samelyuk/volvo-rti-retrofit/(threads)

Thread 2 (2024-08-07):

Inquiry about MCP2025 and Possible Alternatives

Nikolein, 2024-08-07:
Good day,

Where did you purchase the MCP2025 that you use for the steering wheel buttons? Are there alternatives such as the MCP2515?

Best regards,
Niko de Vries

samelyuk, 2024-08-07:
Hello,
I bought the MCP 2025 on tme.eu . You can also use the MCP 2003 or other LIN bus transceiver. The MCP 2515 is for the CAN bus.

Nikolein, 2024-08-07:
Did you order them in 3.3V or 5V?

Closed 2024-08-07.

Thread 3 (2024-08-12):

Verification of Connections: Car to IC and Arduino

Nikolein, 2024-08-12:
Good day,
For the MCP2025-500E/P or MCP2025-330E/P, VBB is Pin 1 of the IC and should be connected to the Arduino Nano. The power supply from the car, which is on Pin 7 of the connector, is connected to the IC’s reset pin. Additionally, the LBus needs to go to the IC, but it is shown connected to the Arduino instead of the car. Is this correct?
MCP2025-500E/P (5V) or MCP2025-330E/P (3.3V)?
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

samelyuk, 2024-08-13:
I have used the MCP 2004, so there is an error. See this guide: https://github.com/laurynas/volvo_linbus

Nikolein, 2024-08-13:
Please make the necessary adjustments in your project, as there is a risk of confusion due to the different pinout configurations of the MCP2004 and MCP2025

samelyuk, 2024-08-13:
Already did it. Sorry for the inconveniences, and thank you for the help.

Nikolein, 2024-08-13:
It’s all good, please.

Nikolein, 2024-08-16:
Hello,
Your project is really great, thank you for sharing it with the community. I noticed a small issue, though: In your diagram from the IC to the Arduino, the blue wire is connected to pin 3 of the IC. It should actually be connected to pin 2 (CS) instead of pin 3 (TXE). It would be great if you could correct that.
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

samelyuk, 2024-08-19:
Thank you for help! I have corrected it.

Closed 2024-08-19.
