samelyuk/volvo-rti-retrofit/RTI Control Module Scheme.pdf

# Arduino Nano - AUX Arduino Nano ⁻ RTI

## Ground Loop

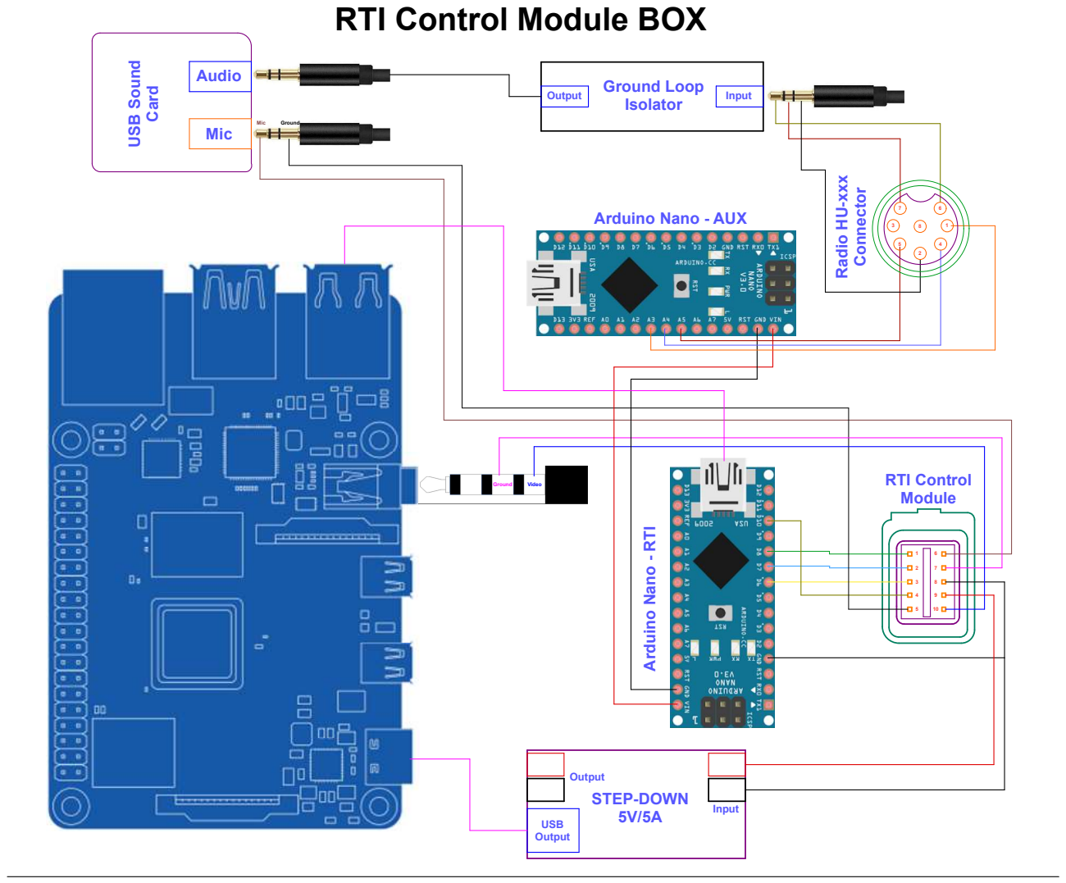
[picture p14: page 1]
RTI Control Module; Input; Output; USB Output; STEP-DOWN 5V/5A; Isolator Output; Input USB Sound Card; Audio; Mic; Ground; Video

RTI Control Module BOX

7 6 Radio HU⁻xxx Connector
