samelyuk/volvo-rti-retrofit/Raspberry Pi/CONFIG.TXT

# For more options and information see
# http://rpf.io/configtxt
# Some settings may impact device functionality. See link above for details

# uncomment if you get no picture on HDMI for a default "safe" mode
#hdmi_safe=1

# uncomment this if your display has a black border of unused pixels visible
# and your display can output without overscan
disable_overscan=0
avoid_warnings=1
enable_tvout=1

# uncomment the following to adjust overscan. Use positive numbers if console
# goes off screen, and negative if there is too much border
overscan_left=-15
overscan_right=-15
overscan_top=-35
overscan_bottom=-20

# uncomment to force a console size. By default it will be display's size minus
# overscan.
#framebuffer_width=1280
#framebuffer_height=720

# uncomment if hdmi display is not detected and composite is being output
#hdmi_force_hotplug=1

# uncomment to force a specific HDMI mode (this will force VGA)
#hdmi_group=2
#hdmi_mode=14
#hdmi_ctv=800 480 60 6 0 0 0
#hdmi_drive=1

# uncomment to force a HDMI mode rather than DVI. This can make audio work in
# DMT (computer monitor) modes
#hdmi_drive=2

# uncomment to increase signal to HDMI, if you have interference, blanking, or

#config_hdmi_boost=4

# uncomment for composite PAL
sdtv_mode=0
sdtv_aspect=3

#uncomment to overclock the arm. 700 MHz is the default.
#arm_freq=800

# Uncomment some or all of these to enable the optional hardware interfaces
#dtparam=i2c_arm=on
#dtparam=i2s=on
#dtparam=spi=on

# Uncomment this to enable the lirc-rpi module
#dtoverlay=lirc-rpi

# Additional overlays and parameters are documented /boot/overlays/README

# Enable audio (loads snd_bcm2835)
dtparam=audio=off
dtoverlay=disable-bt
disable_splash=1
dtoverlay=vc4-fkms-v3d

enable_uart=1

[pi3]
gpu_mem=256
max_framebuffers=1
[pi3+]
gpu_mem=256
max_framebuffers=1

[pi4]
max_framebuffers=2
#hdmi_enable_4kp60=1
